Janga786/hexapod-cpg/hardware/cad/assembly/hexapod_assembly.step

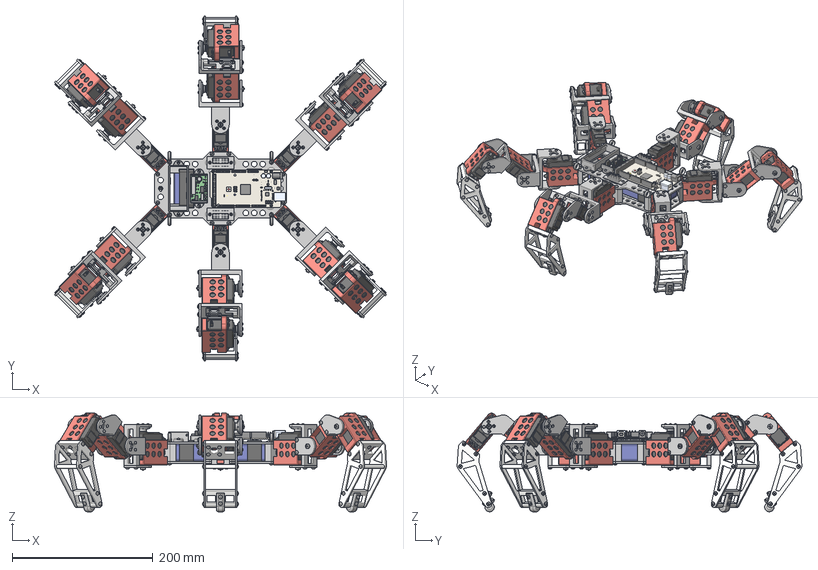
[picture p16: CAD file, 2026-04-29]
hardware/cad/assembly/hexapod_assembly.step
472.5 x 490.6 x 140.5 mm
Servo Wheel x 18
624Z Bearing x 18
Servo Mount x 18
Servo MG996R x 18
Bearing Center x 18
4-40 x 0.375 x 230
4-40 Nut x 54
Tibia Assembly x 6
4-40 x 0.625 x 12
4-40 x 0.500 x 70
SBEC Holder
ArduinoMega
SBEC_1
Receiver Holder
Receiver
Switch
Servo Header x 2
Wire Guide x 4
Battery Strap x 2
