Janga786/hexapod-cpg/hardware/cad/assembly/Foot&Leg Assembly.SLDASM

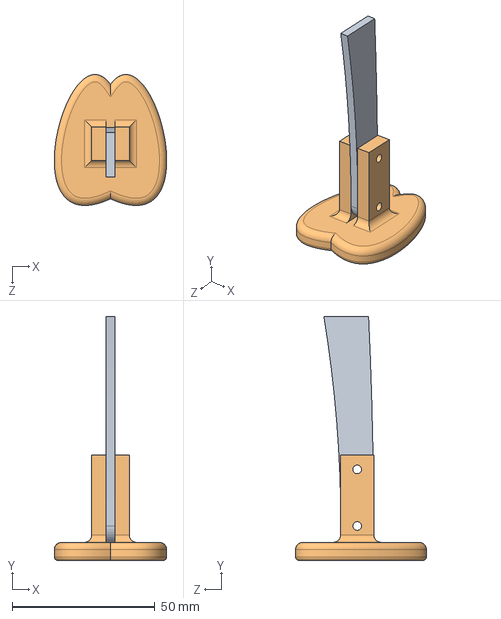
[picture p17: CAD file, 2026-04-29]
hardware/cad/assembly/Foot&Leg Assembly.SLDASM
39.3 x 85.4 x 45.8 mm
Foot Model
Leg Model
