Janga786/hexapod-cpg/hardware/cad/sldprt/Sensor Model.SLDPRT

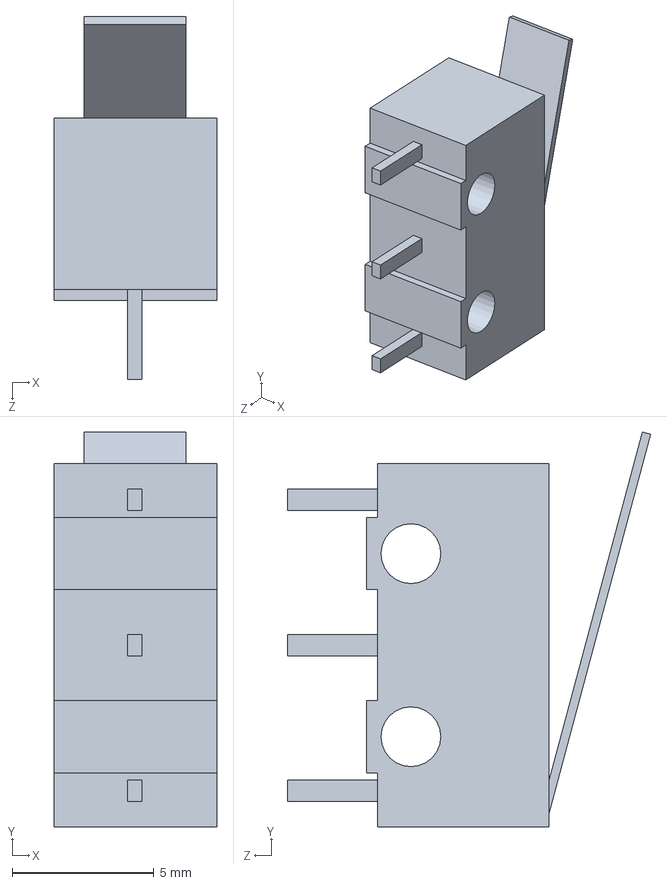
[picture p18: CAD file, 2026-04-29]
hardware/cad/sldprt/Sensor Model.SLDPRT
5.74 x 13.9 x 12.8 mm
