Janga786/hexapod-cpg/hardware/cad/stl/dome bottom_new.STL

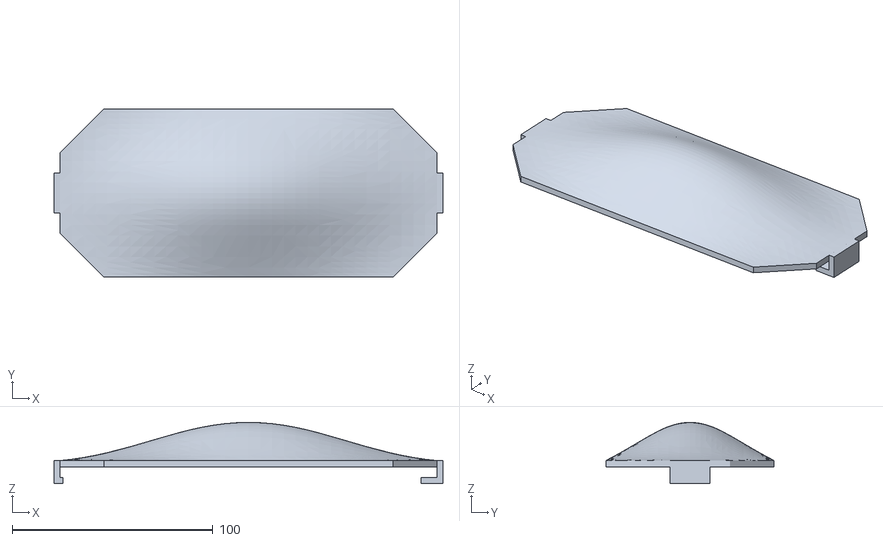
[picture p19: CAD file, 2026-04-29]
hardware/cad/stl/dome bottom_new.STL
194.0 x 84.0 x 30.6
