Janga786/hexapod-cpg/hardware/cad/sldprt/Foot Model.SLDPRT

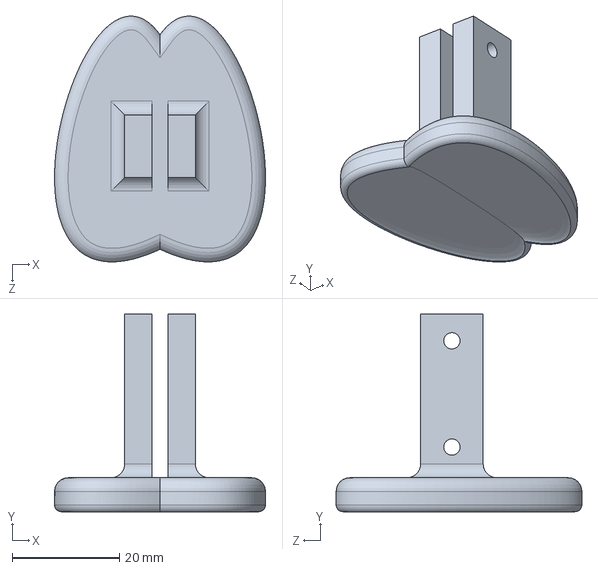
[picture p20: CAD file, 2026-04-29]
hardware/cad/sldprt/Foot Model.SLDPRT
39.3 x 36.8 x 45.8 mm
