Janga786/hexapod-cpg/hardware/cad/stl/Tibia_Bracket.stl

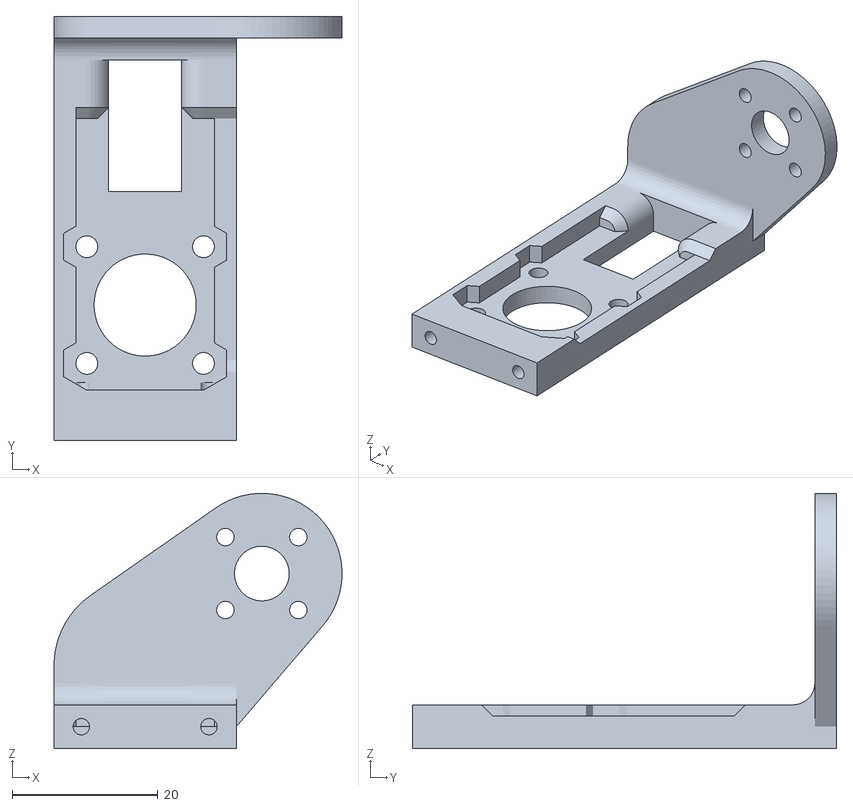
[picture p21: CAD file, 2026-04-29]
hardware/cad/stl/Tibia_Bracket.stl
39.5 x 58.2 x 35.0
