Janga786/hexapod-cpg/hardware/cad/sldprt/FinalFootModelRight.SLDPRT

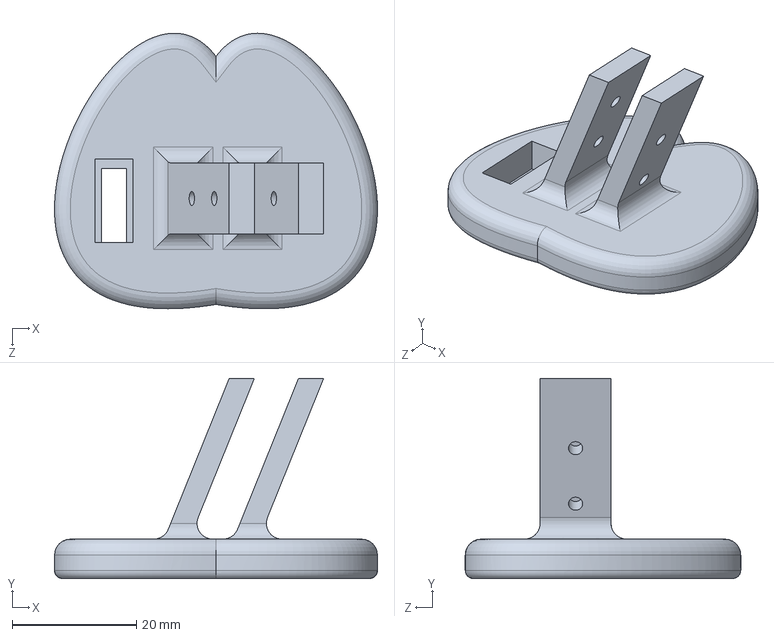
[picture p22: CAD file, 2026-04-29]
hardware/cad/sldprt/FinalFootModelRight.SLDPRT
52.1 x 32.3 x 44.4 mm
