Janga786/hexapod-cpg/hardware/cad/stl/Tibia_Foot_Bumper.stl

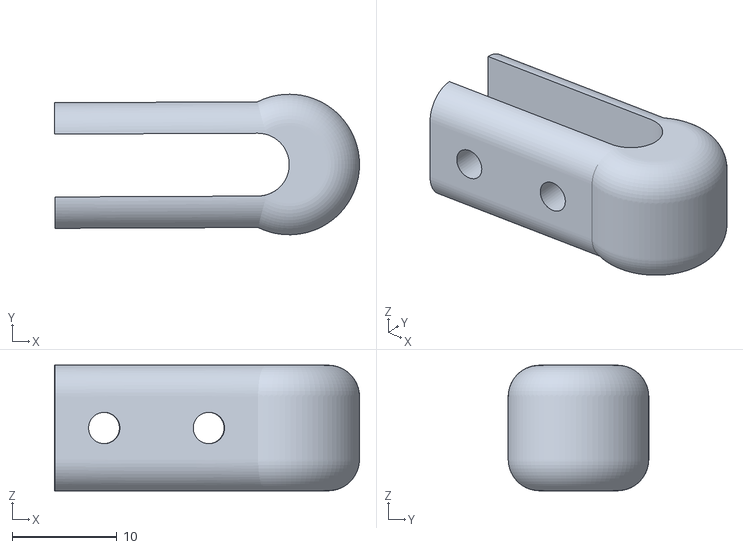
[picture p23: CAD file, 2026-04-29]
hardware/cad/stl/Tibia_Foot_Bumper.stl
29.1 x 13.4 x 12.0
