Janga786/hexapod-cpg/hardware/cad/sldprt/dome bottom _ Final.SLDPRT

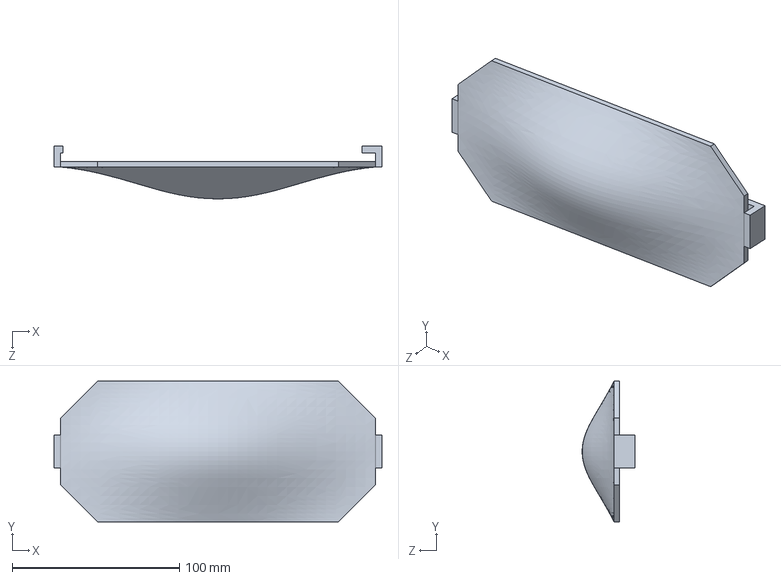
[picture p24: CAD file, 2026-04-29]
hardware/cad/sldprt/dome bottom _ Final.SLDPRT
196.0 x 84.0 x 31.6 mm
