Janga786/hexapod-cpg/hardware/cad/stl/Tibia_Side_1.stl

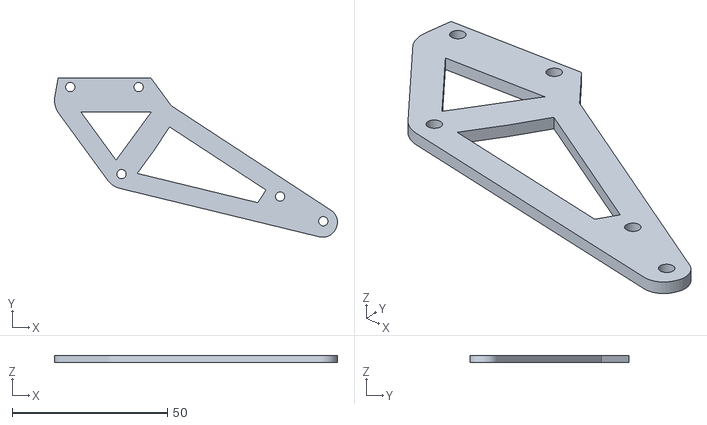
[picture p25: CAD file, 2026-04-29]
hardware/cad/stl/Tibia_Side_1.stl
91.1 x 51.3 x 2.40
