Janga786/hexapod-cpg/hardware/cad/sldprt/Foot Model w Sensor.SLDPRT

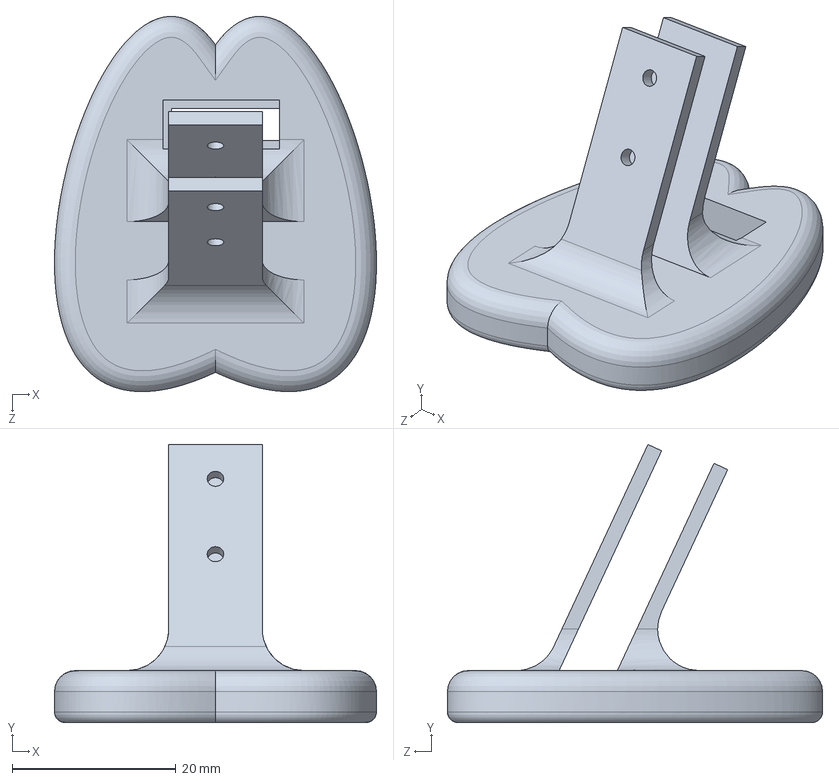
[picture p26: CAD file, 2026-04-29]
hardware/cad/sldprt/Foot Model w Sensor.SLDPRT
39.3 x 34.0 x 45.8 mm
