Janga786/hexapod-cpg/hardware/cad/stl/Body_Bottom_Plate.stl

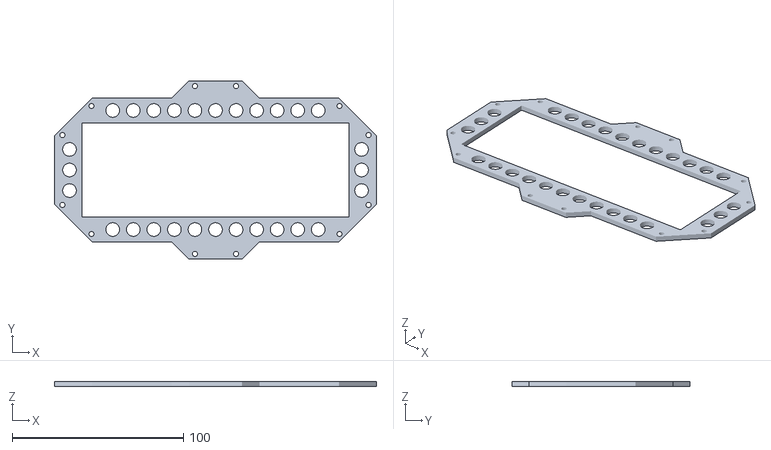
[picture p27: CAD file, 2026-04-29]
hardware/cad/stl/Body_Bottom_Plate.stl
188.0 x 104.0 x 3.00
