Janga786/hexapod-cpg/hardware/cad/sldprt/NewFootRight.SLDPRT

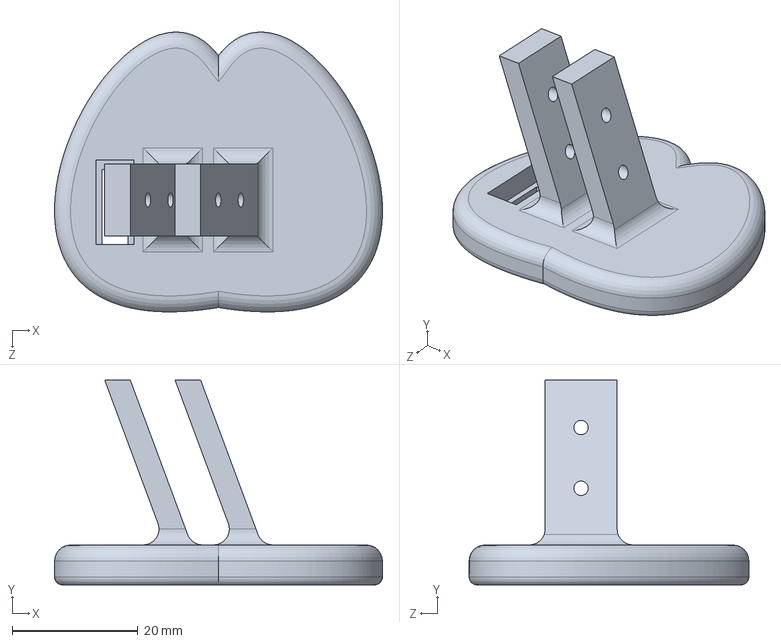
[picture p28: CAD file, 2026-04-29]
hardware/cad/sldprt/NewFootRight.SLDPRT
52.1 x 32.5 x 44.4 mm
