Janga786/hexapod-cpg/hardware/cad/stl/Tibia_Side_2.stl

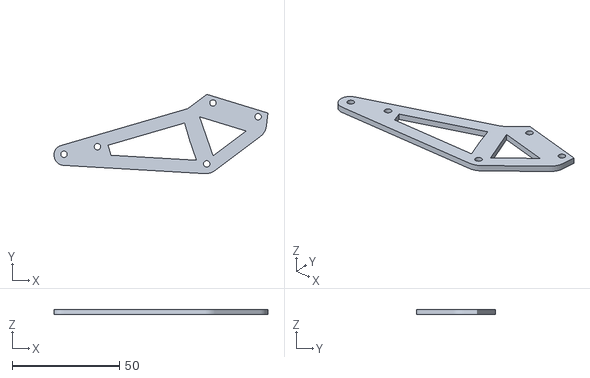
[picture p29: CAD file, 2026-04-29]
hardware/cad/stl/Tibia_Side_2.stl
99.7 x 36.9 x 2.40
