Janga786/hexapod-cpg/hardware/cad/sldprt/BuckConverterHolder.SLDPRT

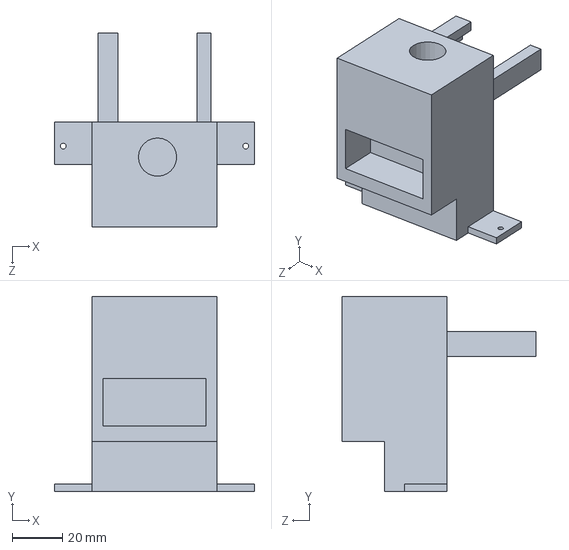
[picture p30: CAD file, 2026-04-29]
hardware/cad/sldprt/BuckConverterHolder.SLDPRT
80.0 x 78.0 x 77.5 mm
