Janga786/hexapod-cpg/hardware/cad/stl/Receiver_Holder.stl

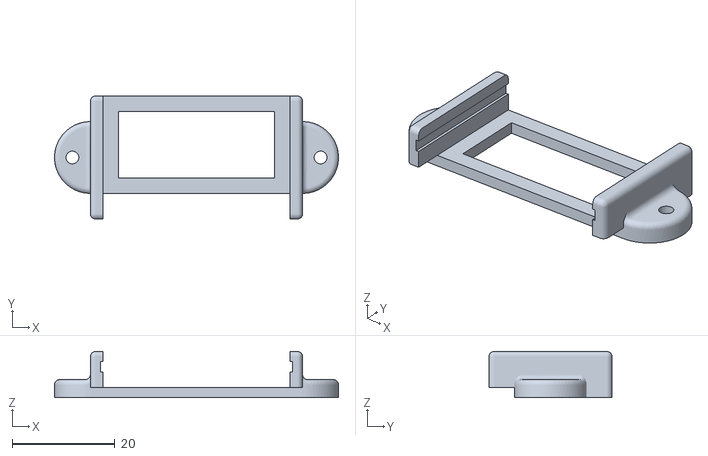
[picture p31: CAD file, 2026-04-29]
hardware/cad/stl/Receiver_Holder.stl
55.4 x 24.0 x 9.00
