Janga786/hexapod-cpg/hardware/cad/stl/Tibia_Spacer_Tube.stl

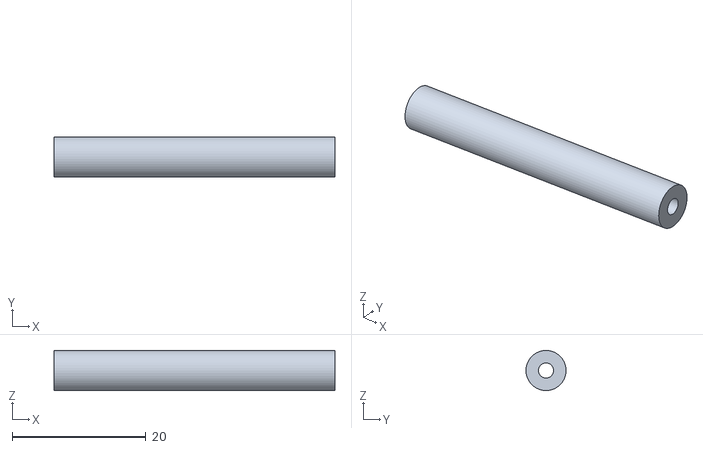
[picture p32: CAD file, 2026-04-29]
hardware/cad/stl/Tibia_Spacer_Tube.stl
42.0 x 5.99 x 6.00
