Janga786/hexapod-cpg/hardware/cad/stl/Tibia_Base_Plate.stl

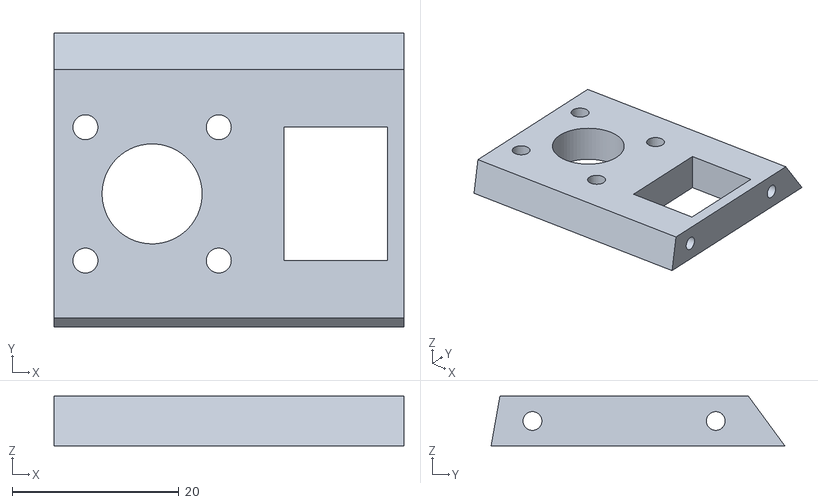
[picture p33: CAD file, 2026-04-29]
hardware/cad/stl/Tibia_Base_Plate.stl
42.0 x 35.3 x 6.00
