Janga786/hexapod-cpg/hardware/cad/stl/Wire_Guide.stl

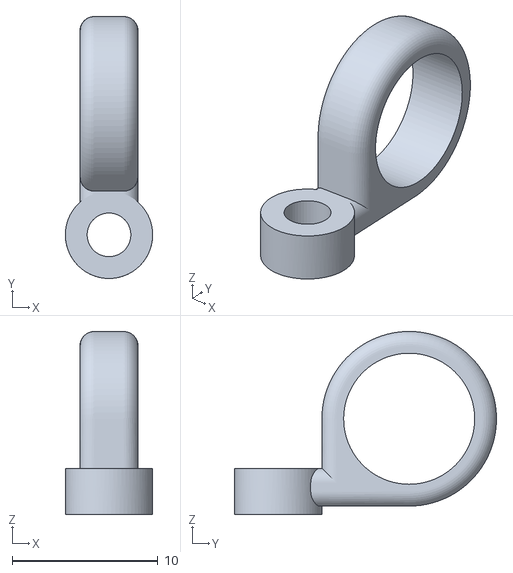
[picture p34: CAD file, 2026-04-29]
hardware/cad/stl/Wire_Guide.stl
6.00 x 18.0 x 12.6
