Janga786/hexapod-cpg/hardware/cad/sldprt/Leg Model.SLDPRT

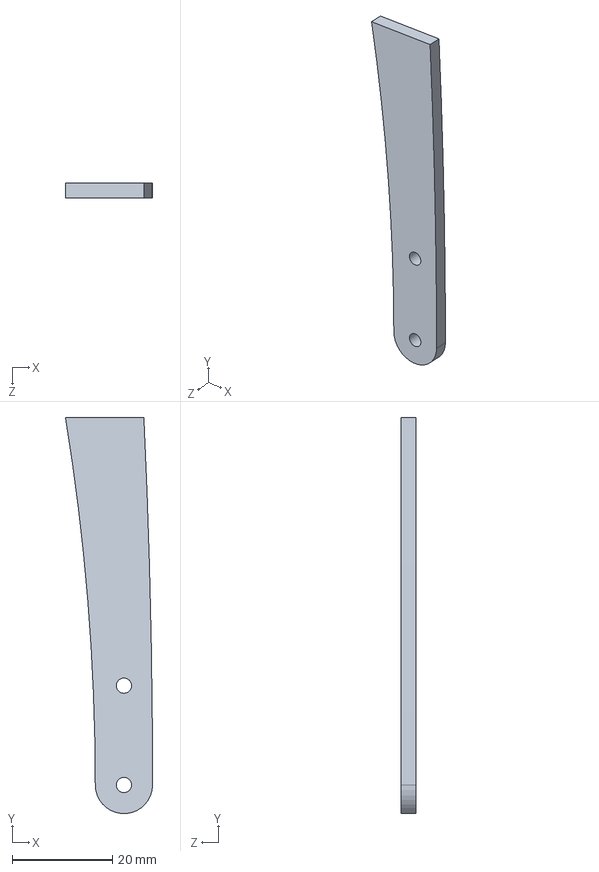
[picture p35: CAD file, 2026-04-29]
hardware/cad/sldprt/Leg Model.SLDPRT
17.4 x 79.0 x 3.05 mm
