Janga786/hexapod-cpg/hardware/cad/stl/SBEC_Holder.stl

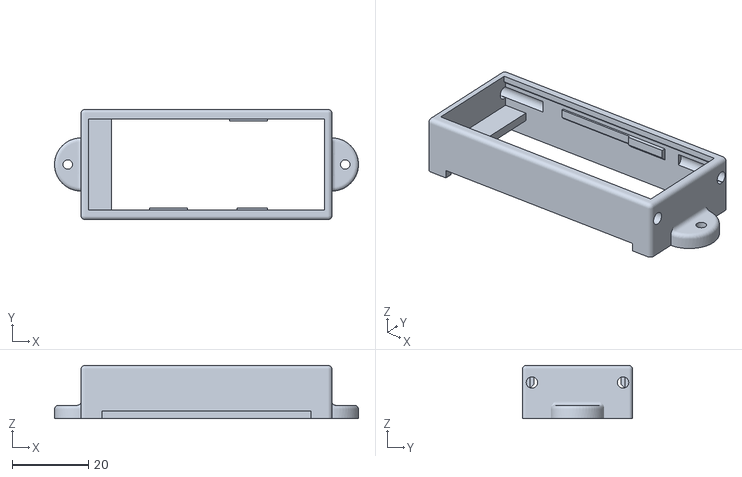
[picture p36: CAD file, 2026-04-29]
hardware/cad/stl/SBEC_Holder.stl
80.0 x 29.0 x 14.0
