Janga786/hexapod-cpg/hardware/cad/sldprt/footmdlws1.SLDPRT

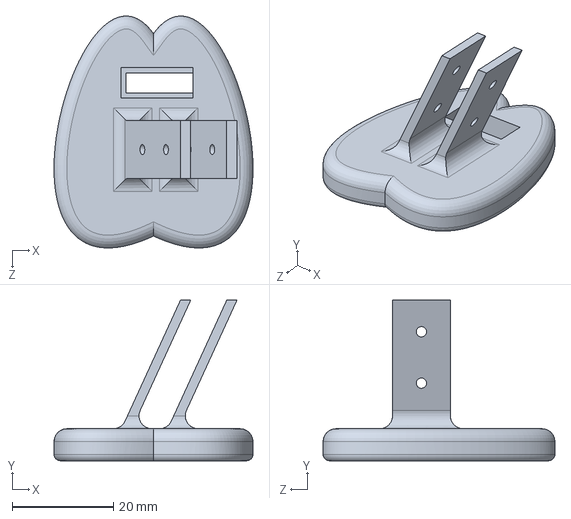
[picture p37: CAD file, 2026-04-29]
hardware/cad/sldprt/footmdlws1.SLDPRT
39.3 x 31.7 x 45.8 mm
