Janga786/hexapod-cpg/hardware/cad/stl/Body_Riser.stl

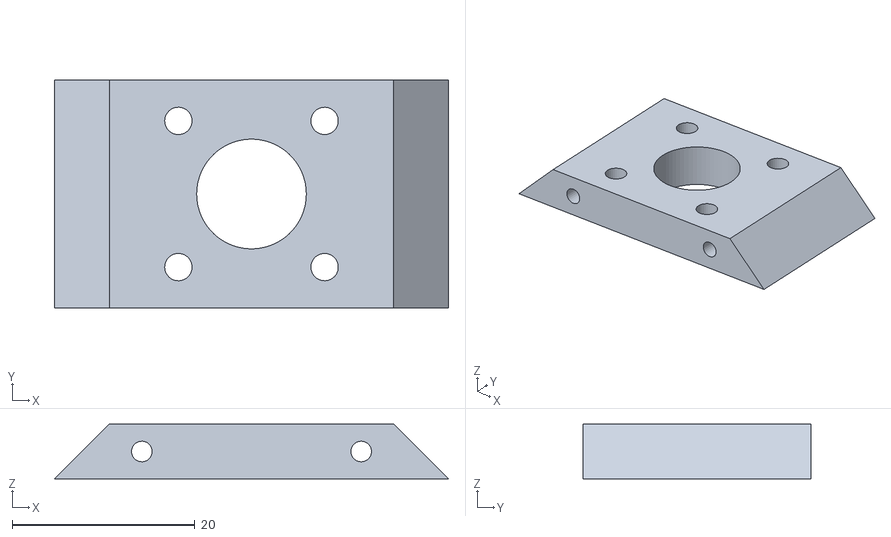
[picture p38: CAD file, 2026-04-29]
hardware/cad/stl/Body_Riser.stl
43.1 x 25.0 x 6.00
