Janga786/hexapod-cpg/hardware/cad/stl/Femur_Bracket_End_Cap.stl

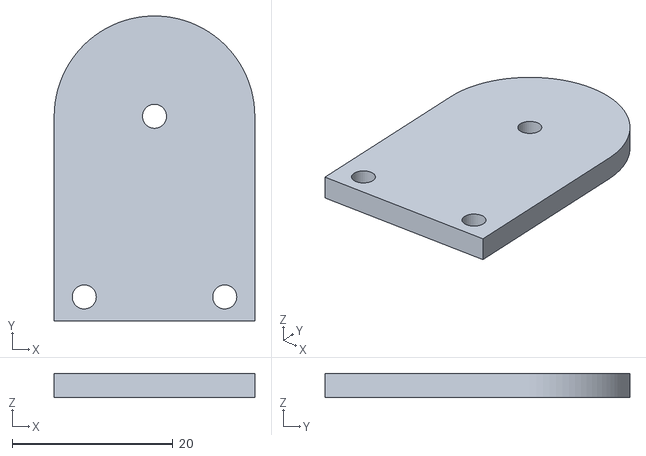
[picture p39: CAD file, 2026-04-29]
hardware/cad/stl/Femur_Bracket_End_Cap.stl
25.0 x 38.0 x 3.00
