Janga786/hexapod-cpg/hardware/cad/stl/Servo_Bearing_Center.stl

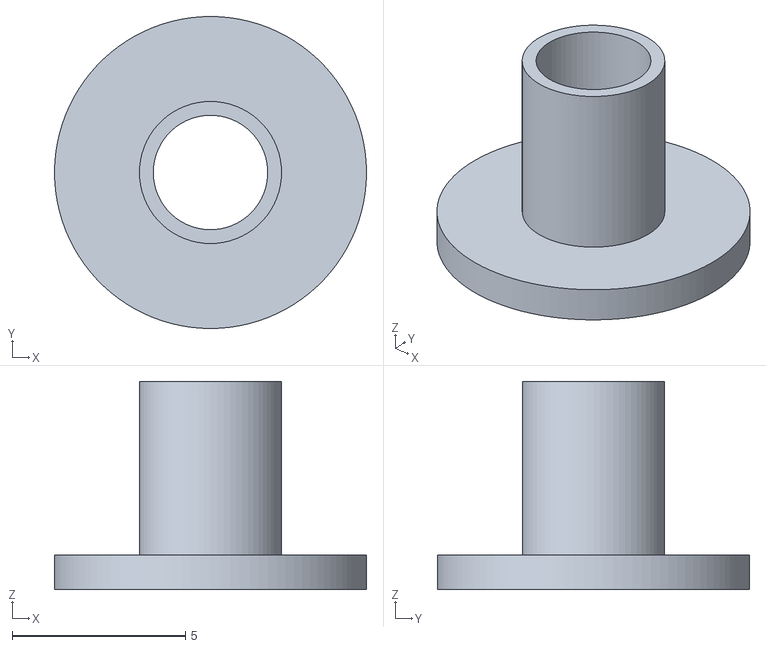
[picture p40: CAD file, 2026-04-29]
hardware/cad/stl/Servo_Bearing_Center.stl
9.00 x 9.00 x 6.00
