Janga786/hexapod-cpg/hardware/cad/stl/Femur_Bracket.stl

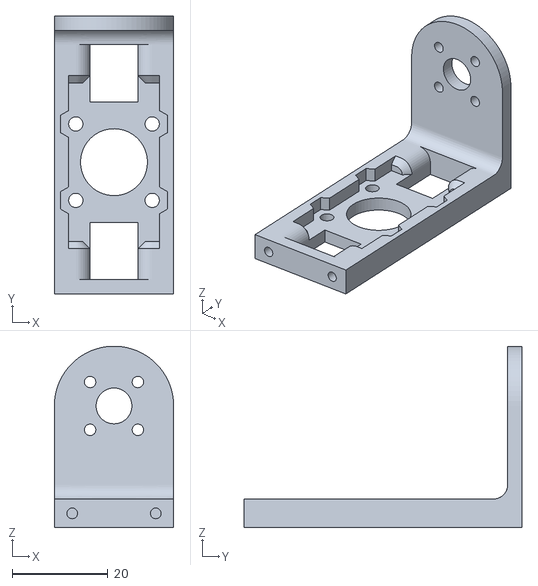
[picture p41: CAD file, 2026-04-29]
hardware/cad/stl/Femur_Bracket.stl
25.0 x 58.2 x 38.0
