Janga786/hexapod-cpg/hardware/cad/stl/Servo_Mount.stl

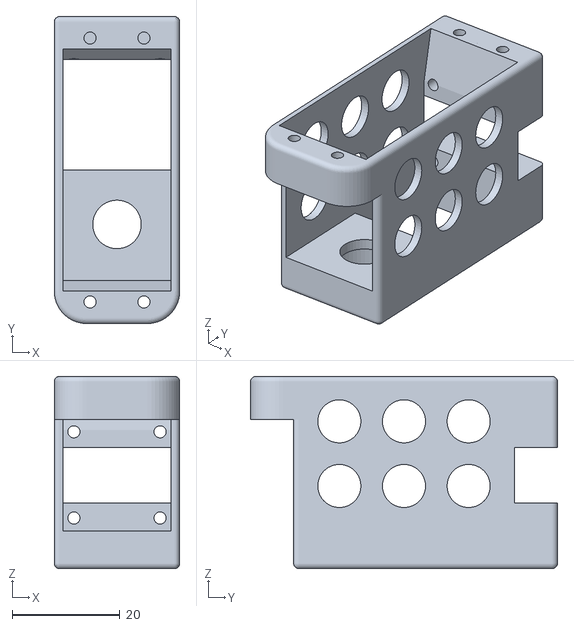
[picture p42: CAD file, 2026-04-29]
hardware/cad/stl/Servo_Mount.stl
23.3 x 57.0 x 35.7
