Janga786/hexapod-cpg/hardware/cad/stl/Body_Top_Plate.stl

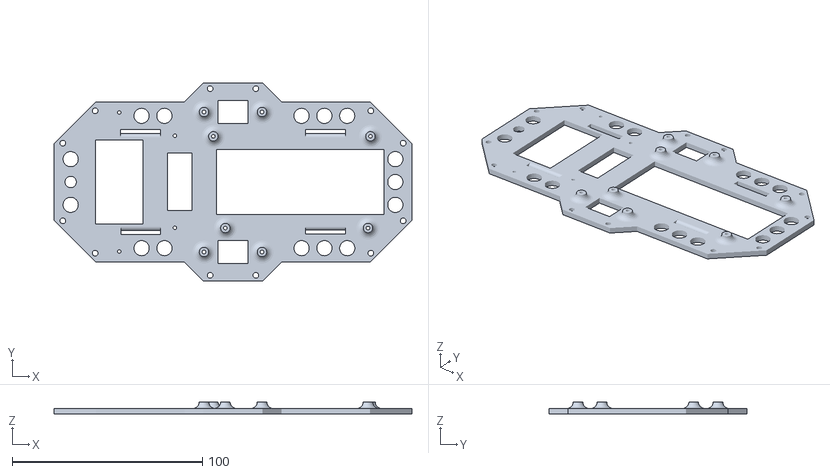
[picture p43: CAD file, 2026-04-29]
hardware/cad/stl/Body_Top_Plate.stl
188.0 x 104.0 x 6.50
