Janga786/hexapod-cpg/hardware/cad/stl/Tibia_Bracket_End_Cap.stl

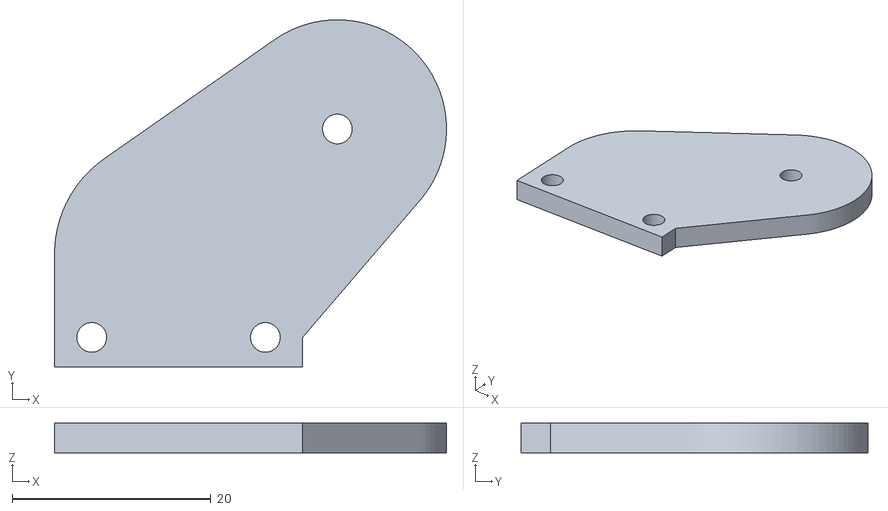
[picture p44: CAD file, 2026-04-29]
hardware/cad/stl/Tibia_Bracket_End_Cap.stl
39.5 x 35.0 x 3.00
