Janga786/hexapod-cpg/hardware/cad/stl/Tibia_Foot_Plate.stl

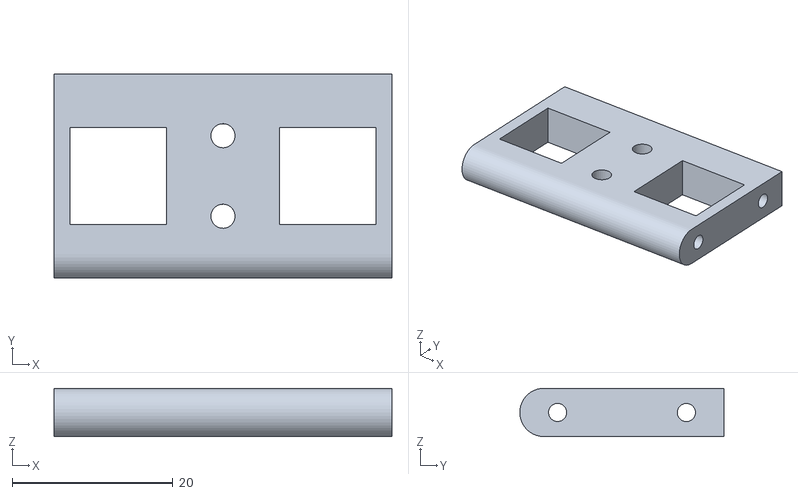
[picture p45: CAD file, 2026-04-29]
hardware/cad/stl/Tibia_Foot_Plate.stl
42.0 x 25.4 x 6.02
