Janga786/hexapod-cpg/(list of files, cad)

Other CAD files:
hardware/cad/sldprt/NewFootLeft.SLDPRT
hardware/cad/sldprt/FinalFootModelLeft.SLDPRT
hardware/cad/sldprt/dome bottom.SLDPRT
hardware/cad/stl/Foot Model w Sensor - Angled.STL
hardware/cad/assembly/Hexapod.f3z
hardware/cad/stl/Foot Model w Sensor.STL
hardware/cad/stl/dome bottom _ Final.STL
