Janga786/hexapod-cpg/docs/printing_instructions.docx

Instructions for Hexapod Skeleton Print

The following parts are printed in PLA at 30% infill, no support material is needed:

- 1 Body Bottom Plate
- 6 Body Risers
- 1 Body Top Plate
- 12 Femur Bracket End Caps
- 12 Femur Brackets
- 18 Servo Bearing Centers
- 6 Tibia Base Plates
- 6 Tibia Bracket End Caps
- 6 Tibia Brackets
- 6 Tibia Foot Plates
- 6 Tibia Sides 1
- 6 Tibia Sides 2 (Note: the tibia sides are identical, they are just printed with opposing sides down)
- 6 Tibia Spacer Tubes

The following parts are printed in PLA at 30% infill with support:

- 1 Receiver Holder
- 1 SBEC Holder
- 18 Servo Mounts
- 6 Wire Guides

The following parts are printed in TPU at 10% infill, no support needed

- 6 Tibia Foot Bumpers
