Janga786/hexapod-cpg/(commit log)

2026-04-29 Initial release: Hexapod CPG — bio-inspired locomotion suite
    A complete hexapod robotics project organised into four pillars:
    - sim/ Python package (hexapod_cpg) implementing a 6-oscillator
    Kuramoto CPG with smooth wave/ripple/tripod gait blending,
    a geometry-faithful 18-DoF inverse-kinematics solver, and
    a real-time 4-panel matplotlib dashboard (3-D body, phase
    wheel, gait diagram, status panel). 34 pytest tests cover
    IK round-trip, coupling-matrix invariants, lock-in
    convergence, perturbation recovery, and gait taxonomy.
    - firmware/ Three Arduino-Mega 2560 sketches: hexapod_full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
    [Body_Bottom_Plate.stl, Body_Riser.stl, Body_Top_Plate.stl, BuckConverterHolder.SLDPRT, Femur_Bracket.stl, Femur_Bracket_End_Cap.stl, FinalFootModelLeft.SLDPRT, FinalFootModelRight.SLDPRT]
2026-10-31 README: explicit attribution and accurate gait claims
    - Attribution section: four-person team, Mark W's chassis skeleton and
    original firmware (heading hold is a modification of it), SparkFun/PS2X
    libraries, and the CPG simulator as later individual simulation-only work
    - State plainly that the CPG has not driven the physical robot
    - Fix duty-factor range (0.62-0.70 over the operating range) and the wave-gait
    stance description; describe gait emergence precisely (designed phase
    targets, dynamics provide the synchronization)
    - Correct name order in CITATION.cff and BibTeX
2026-11-10 hardware/README: credit the print list to Mark W and state the 124-part total
2026-11-10 Citation title and hardware note: describe the robot without calling the chassis custom
